CameronBrooks11/biropette/assets/images/pipette-v15-05.png

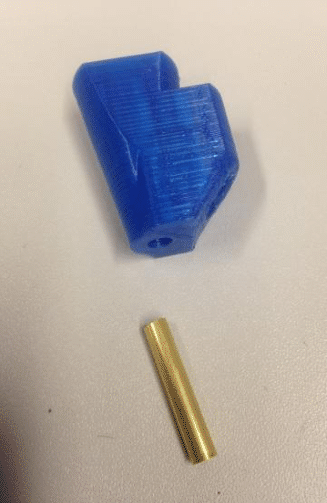
assets/images/pipette-v15-05.png
