CameronBrooks11/biropette/assets/images/pipette-v15-10.png

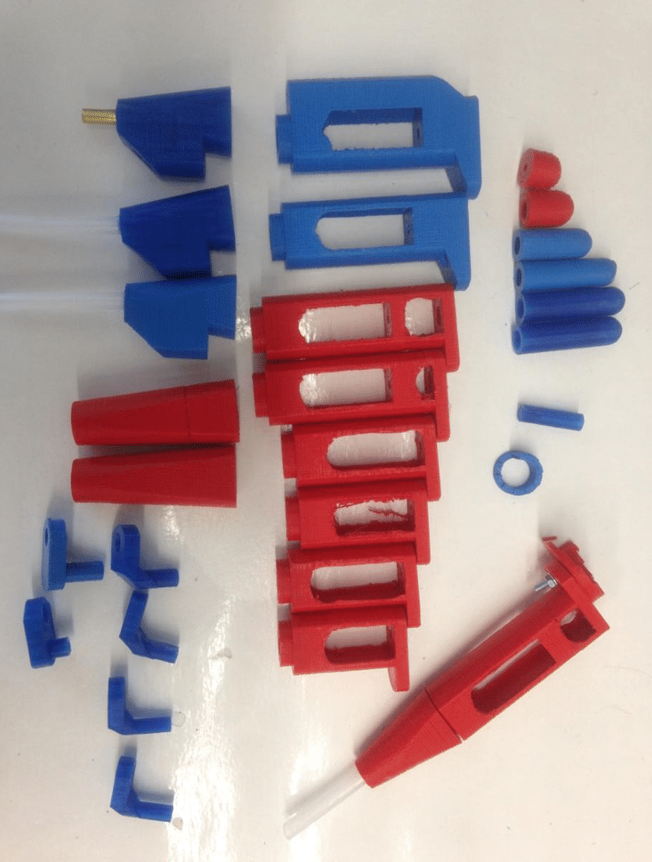
assets/images/pipette-v15-10.png
