CameronBrooks11/biropette/docs/README.md

# Docs

- [design.md](design.md): design basis for v1, covering requirements, the
  ISO 8655 targets, the mechanism, the sizing and the open questions.
- [seal-rig.md](seal-rig.md): making and running the seal friction and leak
  rig.
- [v0/](v0/): the original Biropette guide (pipette v15, 2014).
