CameronBrooks11/biropette/assets/images/pipette-v15-01.png

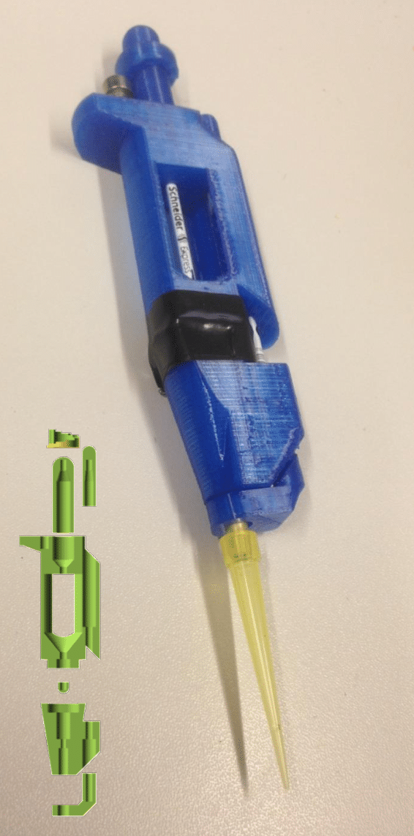
assets/images/pipette-v15-01.png
