CameronBrooks11/biropette/assets/images/pipette-v15-02.png

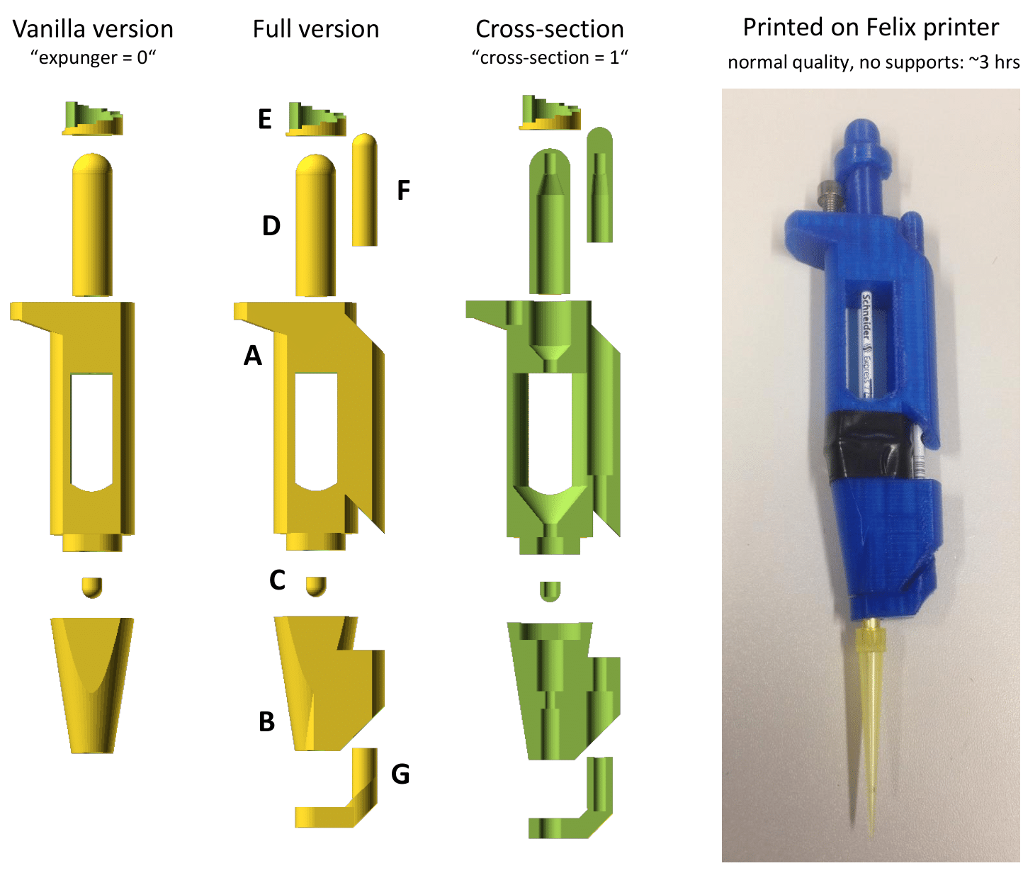
assets/images/pipette-v15-02.png
