CameronBrooks11/biropette/assets/images/pipette-v15-03.png

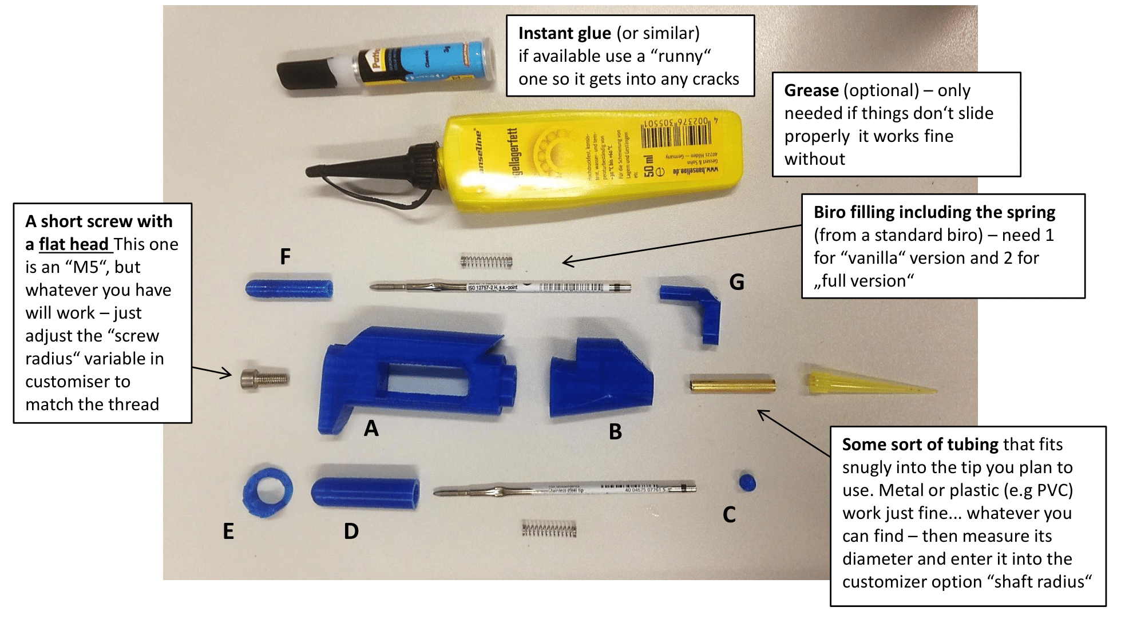
assets/images/pipette-v15-03.png
