CameronBrooks11/biropette/assets/images/pipette-v15-05 copy 3.png

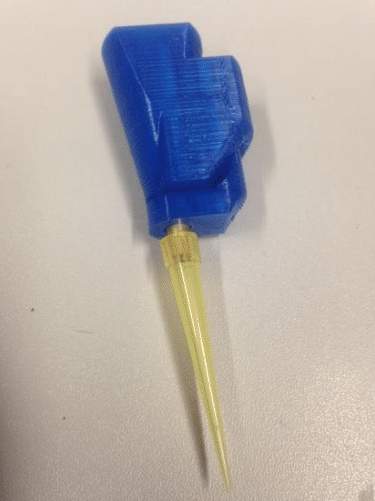
assets/images/pipette-v15-05 copy 3.png
