CameronBrooks11/biropette/assets/images/pipette-v15-05 copy 4.png

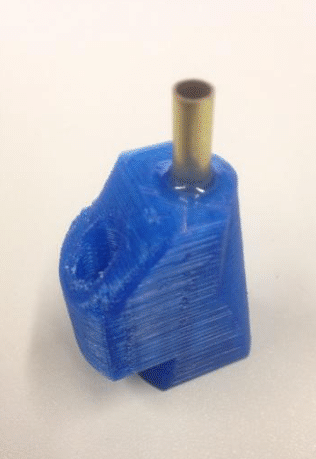
assets/images/pipette-v15-05 copy 4.png
