CameronBrooks11/biropette/assets/images/pipette-v15-05 copy.png

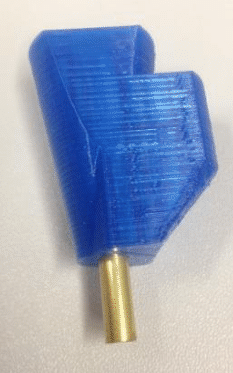
assets/images/pipette-v15-05 copy.png
