CameronBrooks11/biropette/assets/images/pipette-v15-06 copy 2.png

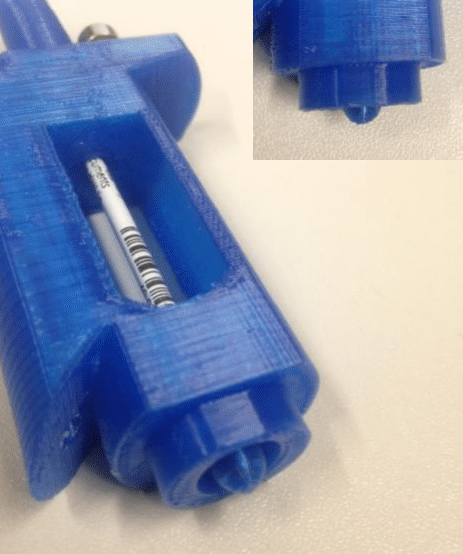
assets/images/pipette-v15-06 copy 2.png
