CameronBrooks11/biropette/assets/images/pipette-v15-06 copy.png

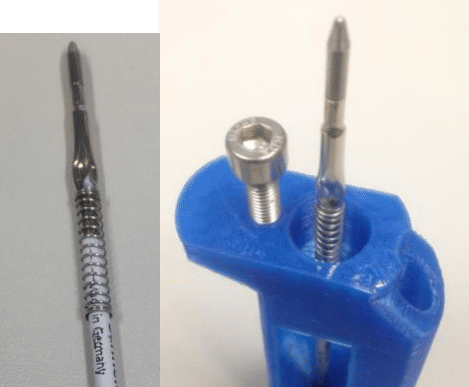
assets/images/pipette-v15-06 copy.png
