CameronBrooks11/biropette/assets/images/pipette-v15-06.png

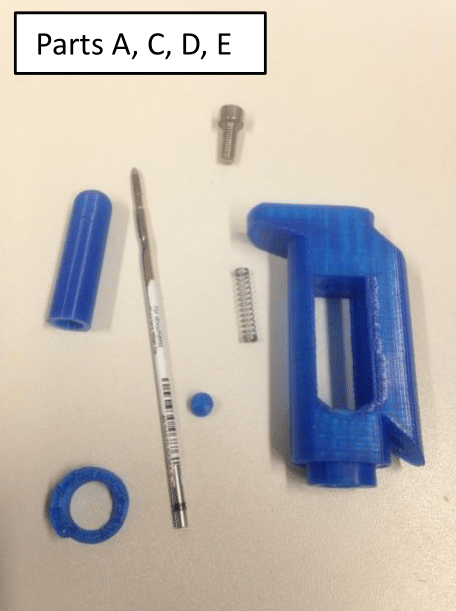
assets/images/pipette-v15-06.png
