CameronBrooks11/biropette/assets/images/pipette-v15-07 copy 3.png

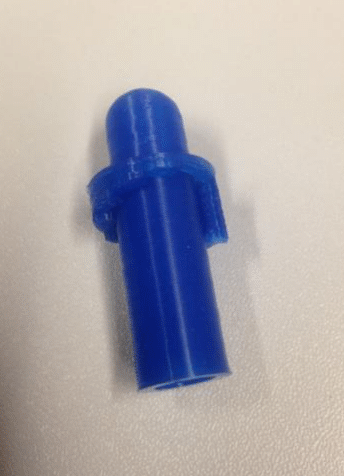
assets/images/pipette-v15-07 copy 3.png
