CameronBrooks11/biropette/assets/images/pipette-v15-07 copy.png

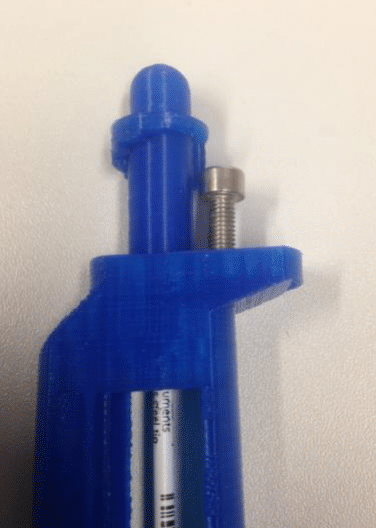
assets/images/pipette-v15-07 copy.png
