CameronBrooks11/biropette/assets/images/pipette-v15-07.png

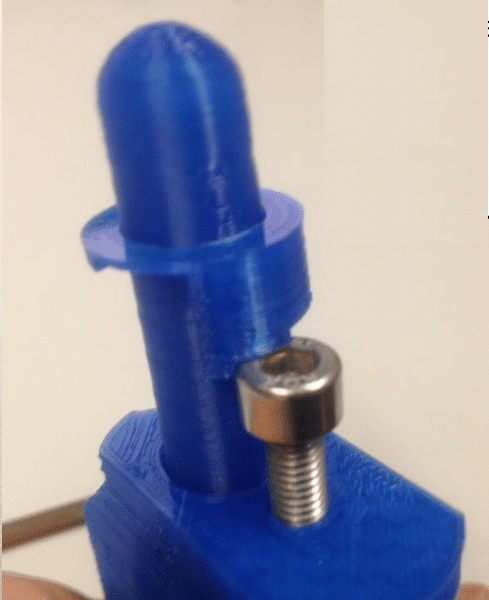
assets/images/pipette-v15-07.png
