CameronBrooks11/biropette/assets/images/pipette-v15-08 copy 3.png

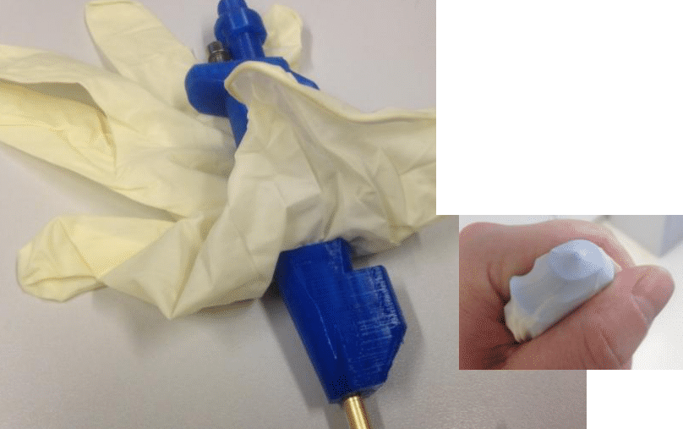
assets/images/pipette-v15-08 copy 3.png
