CameronBrooks11/biropette/assets/images/pipette-v15-08 copy.png

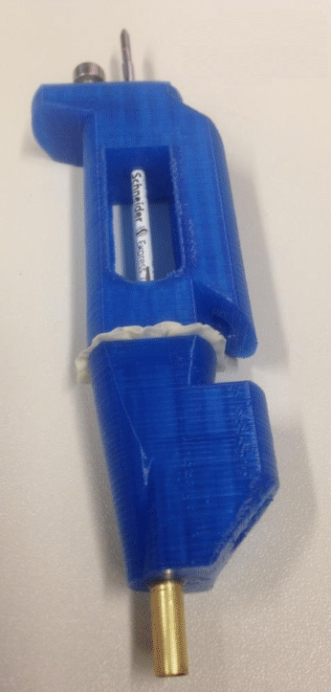
assets/images/pipette-v15-08 copy.png
