CameronBrooks11/biropette/assets/images/pipette-v15-08.png

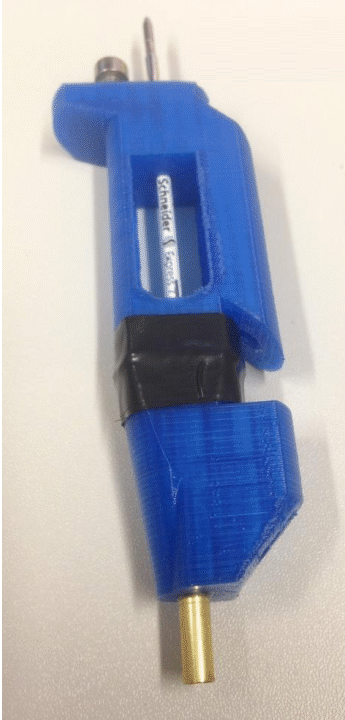
assets/images/pipette-v15-08.png
