CameronBrooks11/biropette/assets/images/pipette-v15-09 copy 2.png

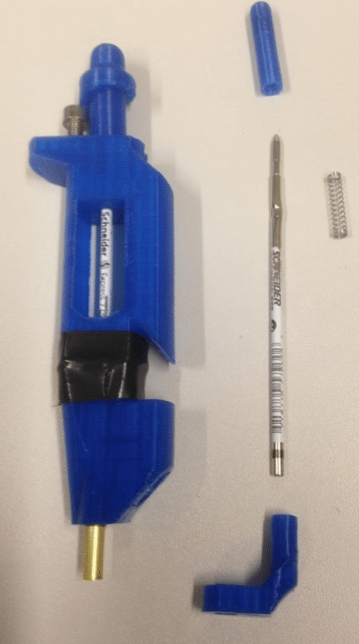
assets/images/pipette-v15-09 copy 2.png
