CameronBrooks11/biropette/assets/images/pipette-v15-09 copy 3.png

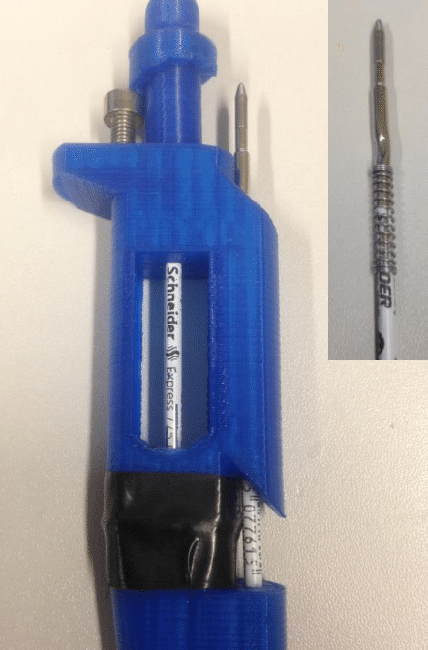
assets/images/pipette-v15-09 copy 3.png
