CameronBrooks11/biropette/assets/images/pipette-v15-09 copy.png

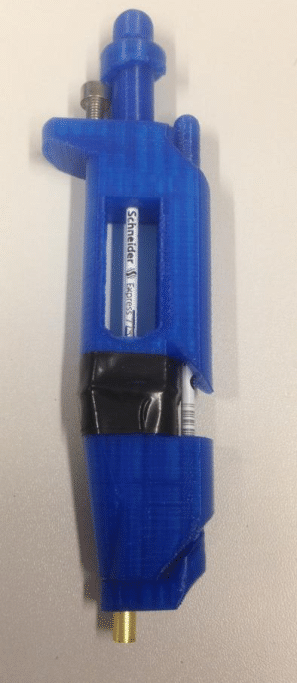
assets/images/pipette-v15-09 copy.png
