CameronBrooks11/biropette/assets/images/pipette-v15-09.png

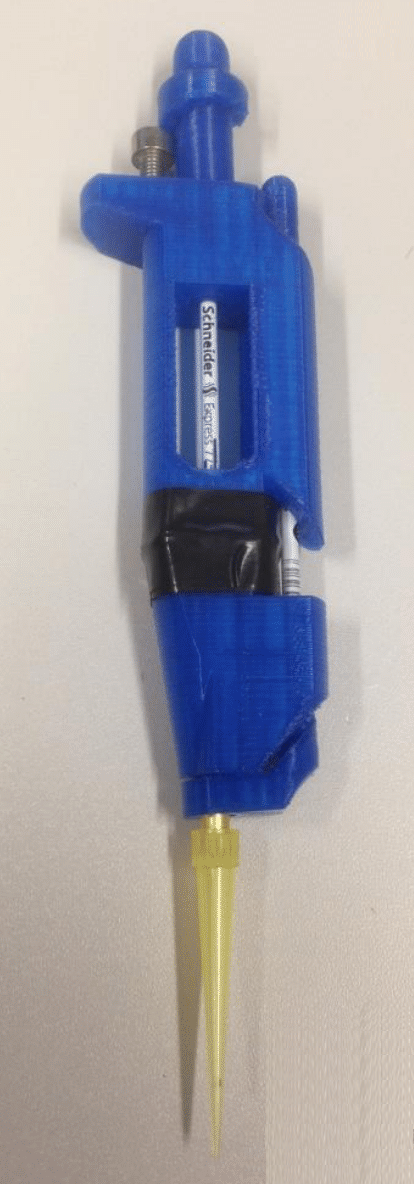
assets/images/pipette-v15-09.png
