CameronBrooks11/biropette/assets/images/pipette-v15-10 copy.png

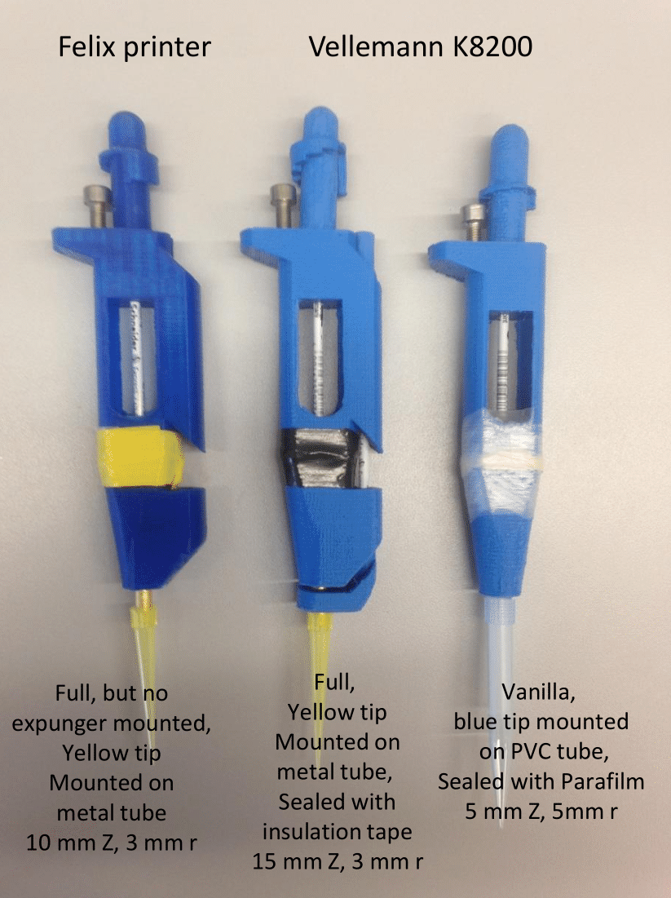
assets/images/pipette-v15-10 copy.png
