CameronBrooks11/biropette/cad/v0/prints/pipette-rack-side-support.stl

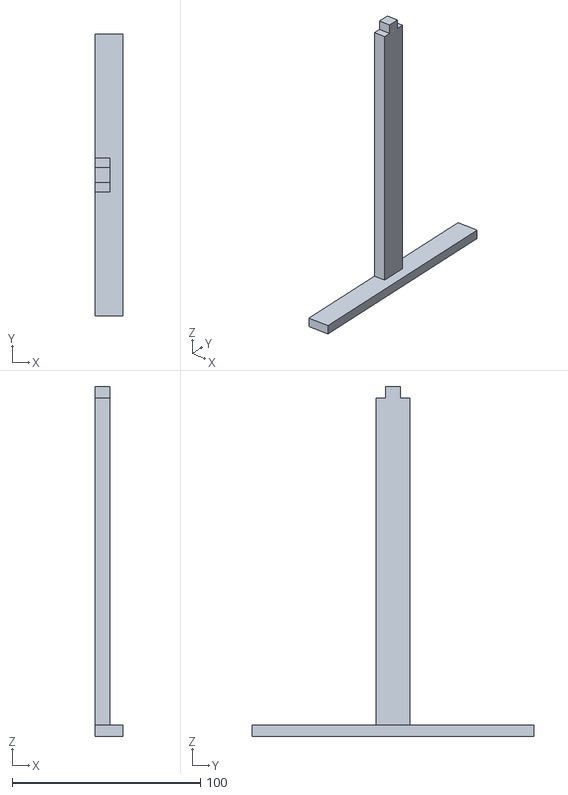
[picture p39: CAD file, 2025-10-13]
cad/v0/prints/pipette-rack-side-support.stl
15.0 x 150.0 x 186.0
