CameronBrooks11/biropette/cad/v0/prints/partF_v0.stl

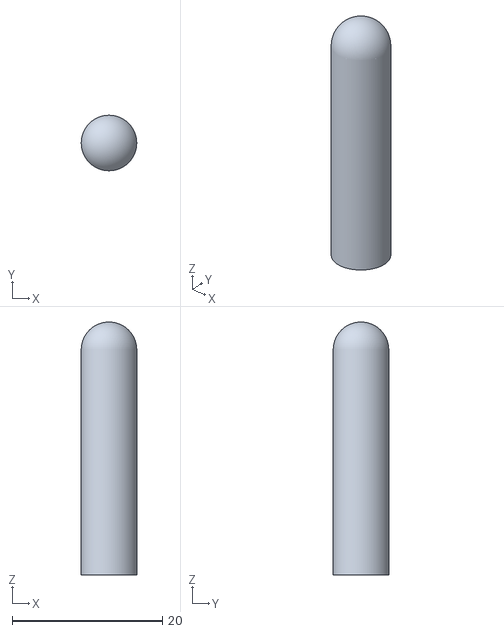
[picture p40: CAD file, 2025-10-13]
cad/v0/prints/partF_v0.stl
7.40 x 7.40 x 33.7
