CameronBrooks11/biropette/cad/v0/prints/partE_v0.stl

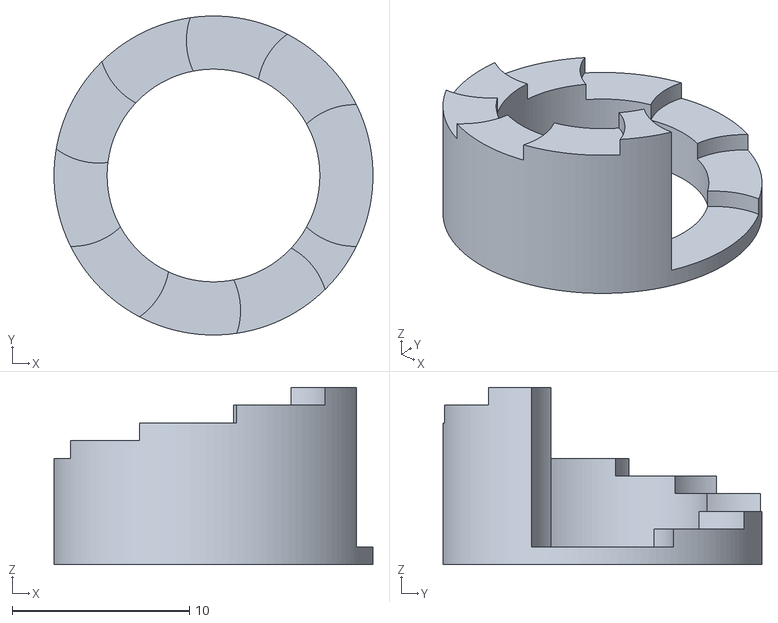
[picture p41: CAD file, 2025-10-13]
cad/v0/prints/partE_v0.stl
18.0 x 18.0 x 10.0
