CameronBrooks11/biropette/cad/v0/prints/partA_v0.stl

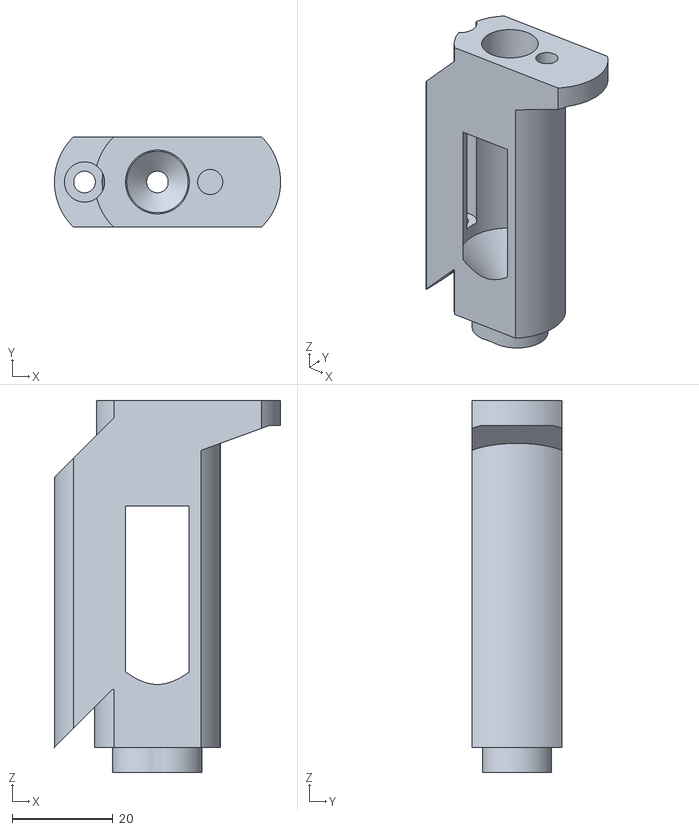
[picture p42: CAD file, 2025-10-13]
cad/v0/prints/partA_v0.stl
45.0 x 18.0 x 74.0
