CameronBrooks11/biropette/cad/v0/prints/partD_v0.stl

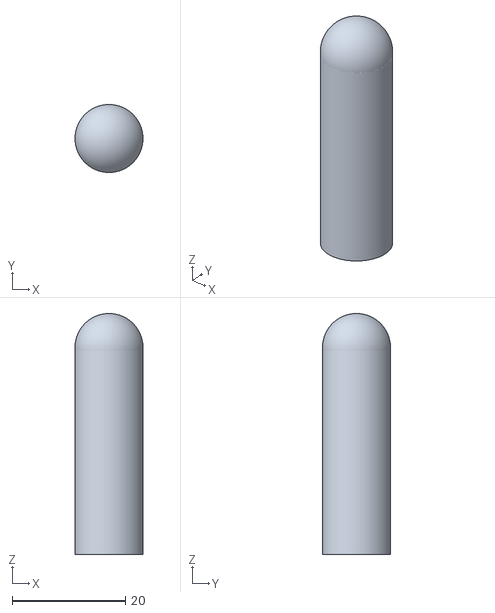
[picture p43: CAD file, 2025-10-13]
cad/v0/prints/partD_v0.stl
12.0 x 12.0 x 42.5
