CameronBrooks11/biropette/cad/v0/prints/biropette_all_parts.3mf

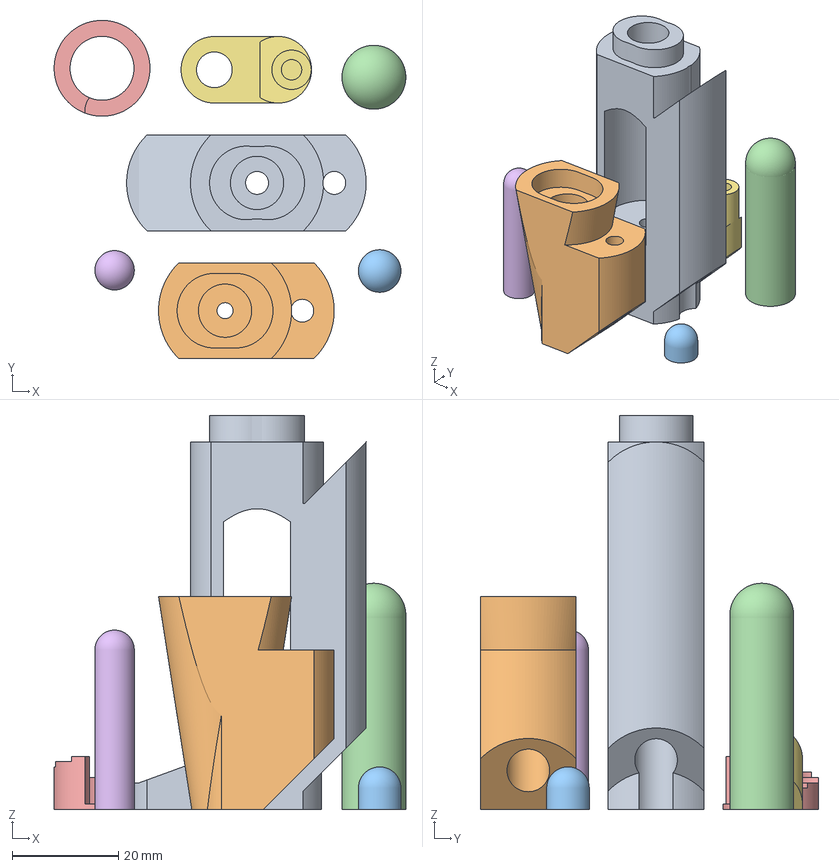
[picture p44: CAD file, 2025-10-13]
cad/v0/prints/biropette_all_parts.3mf
66.1 x 63.5 x 74.0 mm
partA_v0.stl
partB_v0.stl
partC_v0.stl
partD_v0.stl
partE_v0.stl
partF_v0.stl
partG_v0.stl
