CameronBrooks11/biropette/cad/v0/prints/partB_v0.stl

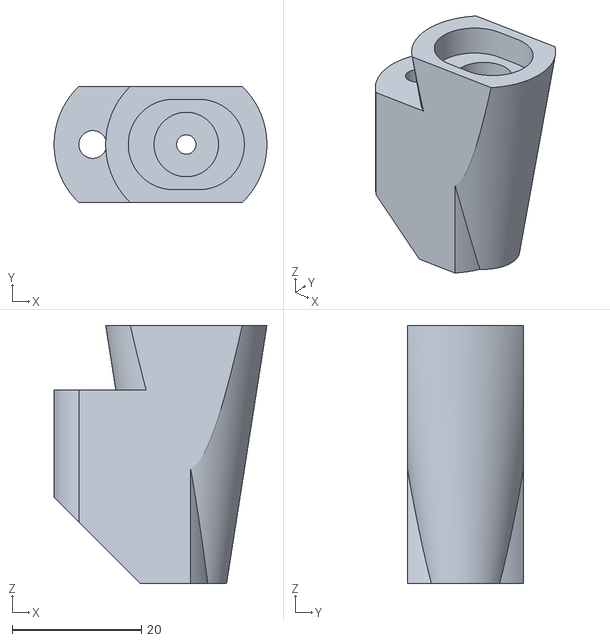
[picture p45: CAD file, 2025-10-13]
cad/v0/prints/partB_v0.stl
33.0 x 18.0 x 40.0
