CameronBrooks11/biropette/cad/v0/prints/pipette-rack-top-beam.stl

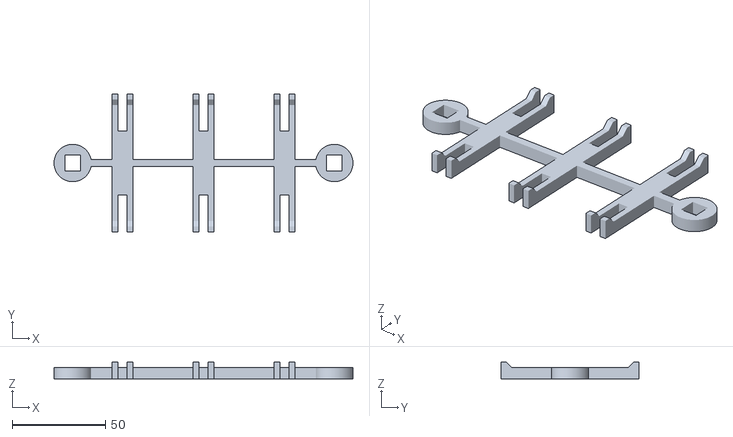
[picture p46: CAD file, 2025-10-13]
cad/v0/prints/pipette-rack-top-beam.stl
160.0 x 74.0 x 9.00
