CameronBrooks11/biropette/cad/v0/prints/partC_v0.stl

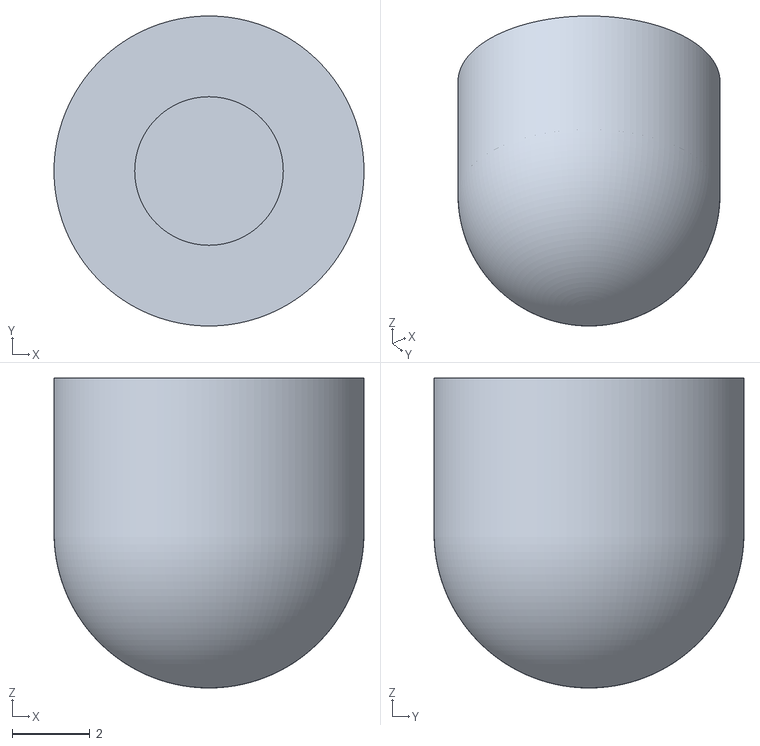
[picture p47: CAD file, 2025-10-13]
cad/v0/prints/partC_v0.stl
8.00 x 8.00 x 8.00
