CameronBrooks11/biropette/cad/v0/prints/partG_v0.stl

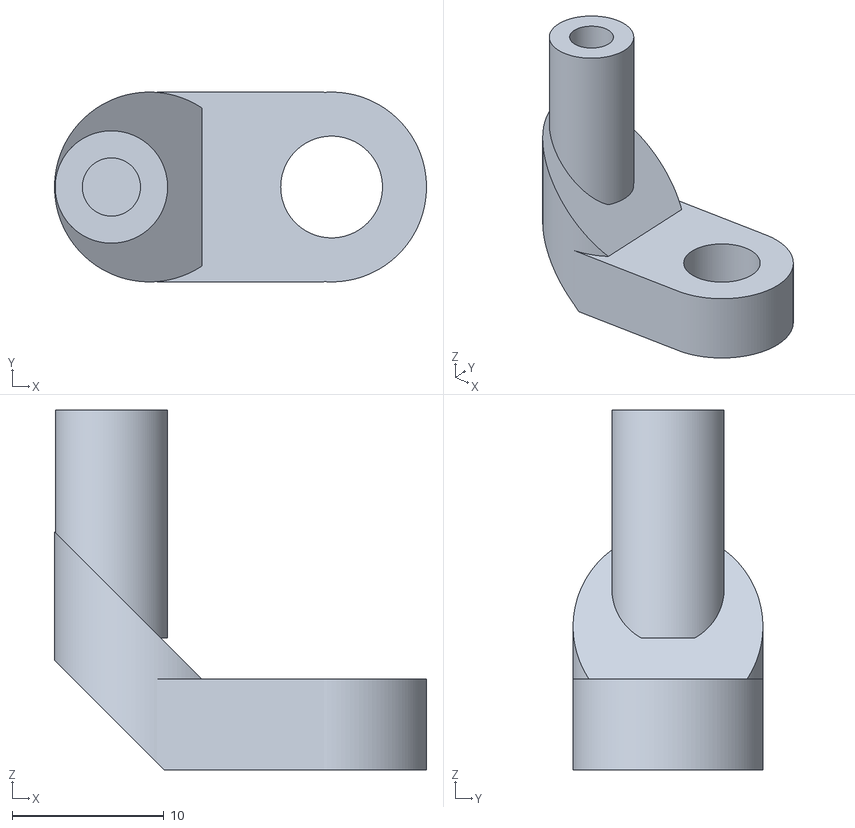
[picture p48: CAD file, 2025-10-13]
cad/v0/prints/partG_v0.stl
24.5 x 12.5 x 23.7
