CameronBrooks11/biropette/cad/v0/prints/pipette-rack.3mf

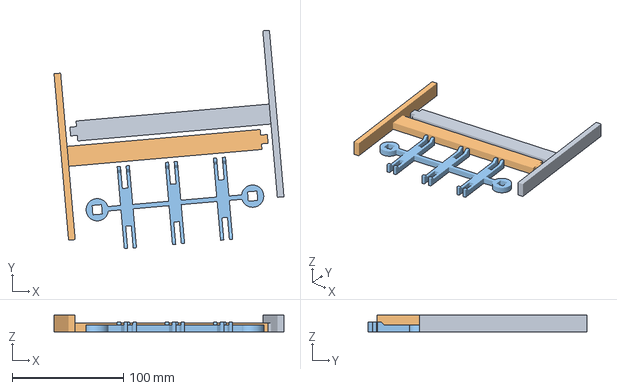
[picture p49: CAD file, 2025-10-13]
cad/v0/prints/pipette-rack.3mf
206.4 x 196.1 x 15.0 mm
pipette-rack-side-support.stl
pipette-rack-top-beam.stl
