CameronBrooks11/biropette/(commit log)

2025-10-12 update z fight and name
    [biropette.scad, pipette.scad]
2025-10-12 revise da rack
    [pipette-rack.scad]
2025-10-12 fixed z fighting on rack models
    [pipette-rack.scad]
2025-10-13 add initial run of prints
    [biropette_all_parts.3mf, partA_v0.stl, partB_v0.stl, partC_v0.stl, partD_v0.stl, partE_v0.stl, partF_v0.stl, partG_v0.stl]
2025-10-13 add rack src link
    [pipette-rack.scad]
2026-11-07 refactor(cad): freeze the original biropette under cad/v0
    Move the 2014 pipette and rack models, their print files and the
    original guide into cad/v0/ and docs/v0/ so the v1 redesign can be built
    alongside them. The files are unchanged; cad/v0/README.md records where
    they came from.
    [biropette_all_parts.3mf, partA_v0.stl, partB_v0.stl, partC_v0.stl, partD_v0.stl, partE_v0.stl, partF_v0.stl, partG_v0.stl]
2026-11-07 build: add a render gate for the OpenSCAD models
    just check renders every entry to CSG and just test exports STL. Both
    fail on any OpenSCAD warning or error, on output with no geometry, and
    (for STL) on a non-manifold mesh, because OpenSCAD exits 0 on undefined
    variables and failed asserts. Renders default to OpenSCAD 2021.01.
    Before: no command checked the models. After: an undefined variable, a
    failed assert and a file that draws nothing each fail; both v0 entries
    pass check and test on 2021.01, and check also on 2026.10.03.
2026-11-07 docs: add the v1 design basis and agent instructions
    docs/design.md sets out the adjustable single-channel redesign: P200 and
    P1000 first, ISO 8655-2 targets, a bought piston, seals and metal stops,
    the sizing behind them and the open questions. Each figure is labelled
    with its source; scripts/sizing.py produces the derived ones.
    AGENTS.md records the layout, the commands and the conventions for
    keeping purchased-part data apart from geometry.
2026-11-07 feat(cad): derive P200 and P1000 from registered parts
    Add registries for the bought parts (dowel-pin pistons, O-rings, spindle
    threads, tips), the size requirements and the ISO 8655-2 limits, and a
    layout() that derives the stroke, seal gland, spindle figures and pin
    length from them. cad/main.scad prints the result with part=report;
    just report <size> shows it and just check derives every size.
    Tip dimensions stay undef until measured, and the report lists them,
    with the dead air volume, springs and pin stock lengths, as not yet
    evaluable. Each departure and assert was triggered deliberately and
    fired.
    docs/design.md notes that the pin's m6 band is a gain error: a scale on
    the nominal 4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
    [iso8655.scad, layout.scad, main.scad, orings.scad, pistons.scad, report.scad, sizes.scad, threads.scad]
2026-11-07 chore: license v0 under CC BY-SA 4.0 and v1 under the lab policy
    Both upstream Thingiverse things (255519, 257254) are CC BY-SA 4.0, so
    the adapted v0 files keep that licence, with attribution and the 2025
    changes listed in LICENSING.md. The v1 redesign is new work and takes
    GPL-3.0-or-later for software and CERN-OHL-S-2.0 for hardware, with
    parametric CAD source under both.
    The root LICENSE becomes the plain GPL text in place of a notice carried
    over from another project, and the licence texts take their SPDX names.
2026-11-07 feat(cad): register sleeves, collars and springs and check thumb forces
    The volume is set by a hollow threaded sleeve whose lower face is the
    upper stop. No bought sleeve clears an 8 mm pin and stock 4 mm pins end at
    40 mm, so a 4 mm rod passes through the sleeve, carries a stop collar and
    drives a separate piston pin. The solid-thread registry is replaced by
    sleeve, collar and Gutekunst spring registries, and pin stock lengths are
    recorded from supplier listings.
    layout() now fits both springs, estimates seal friction from Parker's
    coefficients, and reports the thumb force at the first stop and through
    blow-out against measured commercial pipettes. At the planning friction
    the P200 lands j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
    [collars.scad, ergonomics.scad, layout.scad, main.scad, pistons.scad, report.scad, sizes.scad, sleeves.scad]
2026-11-08 feat(cad): add a seal rig to measure piston-seal friction and leak
    The spring choice, and whether the P1000 can reach commercial thumb
    forces, both depend on the seal's real friction, and a printed radial
    gland may not hold its squeeze to better than +/-7 %. The rig holds one
    size's piston pin and O-ring in either a radial gland printed at size or
    an axial gland whose cap compresses the ring, so both can be tested on a
    kitchen scale.
    seal_rig() derives the body, cap, plug and screws from the registered
    parts; just report prints what to drill, measure and buy and the leak-test
    travel and reading. The rig parts join the CSG and STL gates, and
    docs/seal-rig.md gives the procedure.
    [fasteners.scad, layout.scad, main.scad, report.scad, seal_rig.scad]
2026-11-08 docs: add seal-rig parts list and a just print export
    docs/seal-rig.md gains the parts for all four rigs as requirement plus
    candidate, with McMaster-Carr part numbers and prices read 2026-11-08
    (about $78, plus optional stainless pins). just print exports the eight
    printed rig parts to build/print/ under readable names, with the same
    checks as just test. AGENTS.md lists the recipe and no longer says
    report is the only part.
